Guillaume4242/modern_cuckoo/docs/images/decorative-cover.jpg

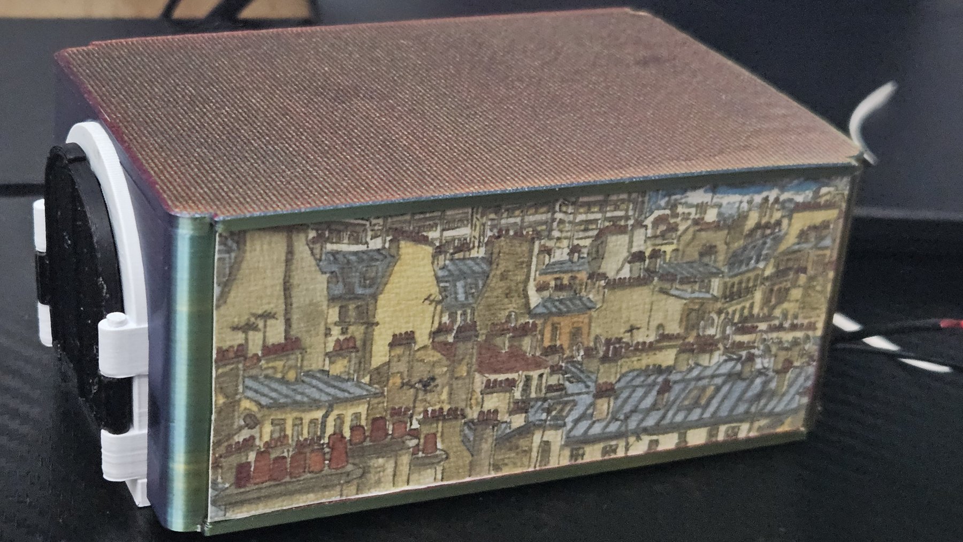
docs/images/decorative-cover.jpg
