Guillaume4242/modern_cuckoo/docs/images/firmware-files.png

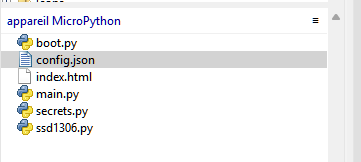
docs/images/firmware-files.png
