Guillaume4242/modern_cuckoo/docs/images/interface-sounds.png

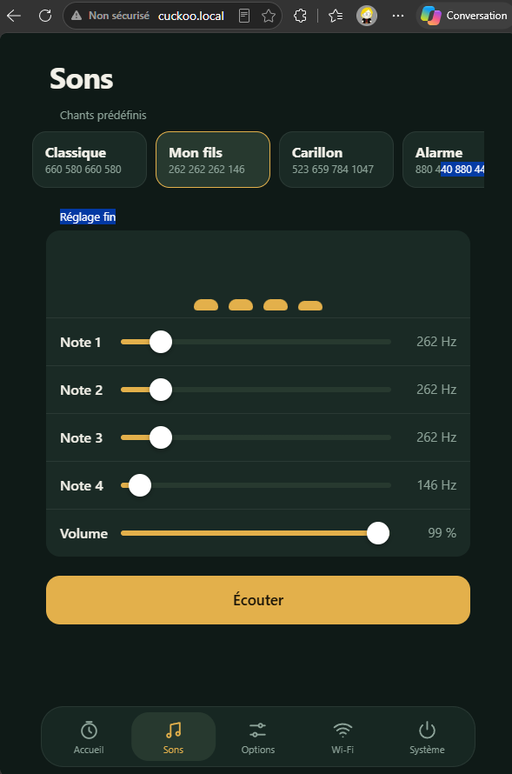
docs/images/interface-sounds.png
