Guillaume4242/modern_cuckoo/docs/images/interface-welcome.png

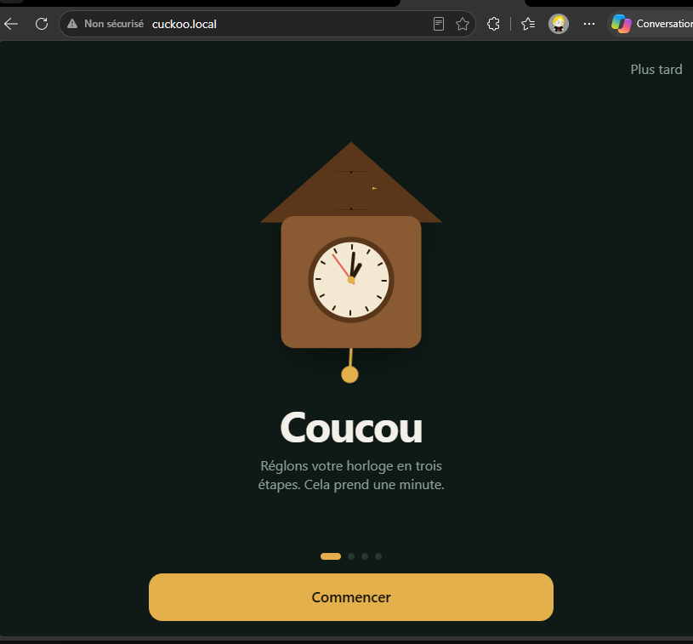
docs/images/interface-welcome.png
