Guillaume4242/modern_cuckoo/3d-files/Modern Cuckoo V5.3mf

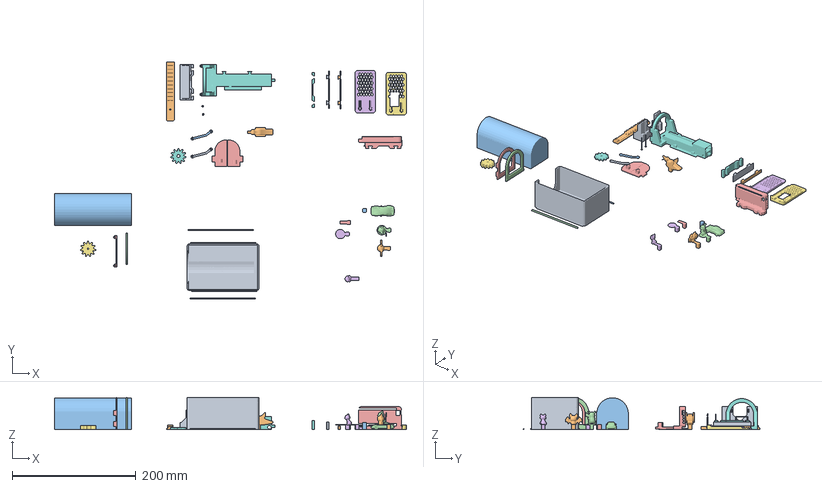
[picture p9: CAD file, 2026-11-11]
3d-files/Modern Cuckoo V5.3mf
568.3 x 382.8 x 52.3 mm
KK_pendel2.stl x 2
KK_bird.stl
Assemblé x 14
KK_luikframe.stl
Cover ESP
Encoche femelle
Encoche Male
Encoche Male petite hauteur
Moule partie interne
FrameBack
KK_luiken.stl
Support 911
Assemblé_Boolean
Rainure Bas 1
Rainure Bas 2
